LanaDGH/Laserska-komunikacija/README.md

# Laserska-komunikacija
Communication of two PCs by Arduino controlled lasers

Detailed description of the project is in the PDF file.
Authors: Anja Mijailović, Lana Dermanov
Menthors: Dragan Mićić, Andrej Lojdl
